digital-un-2026-2/FPGBC_digital_UN/identified_pins/chips.md

## Gowin GW2AR-LV18EQ144PC8/I7 https://www.gowinsemi.com/en/product/arora-ii-fpga/ (placed)

## WCH CH32V203 C8T6 https://www.wch-ic.com/products/CH32V203.html (placed)

## HGSEMI 24C04C  https://www.microchip.com/en-us/product/at24c04c (placed)

## LJ24SA TI 62K CJDC 8 Bit Level Shifter https://www.ti.com/lit/ds/symlink/sn74lvc8t245.pdf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

## YF04E TI 4AK AZD3 4 Bit Level Shifter https://www.ti.com/lit/ds/symlink/txb0104.pdf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

## LPS LP28303A https://www.lowpowersemi.com/Product-detail/17-LP28303A?parent_id=17

## TC8002D Audio Amplifier https://jarl-mie.com/01/image/tec2020/HXJ8002_Miniature_Audio_Amplifier_Datasheet.pdf (placed)

## WINBOND 25Q16JVSIQ SPI Flash https://www.digikey.es/es/products/detail/winbond-electronics/W25Q16JVSSIQ/6193769 (placed)

## EA3059 https://wiki-power.com/en/%E7%94%B5%E6%BA%90%E6%96%B9%E6%A1%88%EF%BC%88PMIC%EF%BC%89-EA3059/ (placed)

## TT5 1D https://www.ti.com/lit/ds/symlink/txs0101.pdf
