digital-un-2026-2/FPGBC_digital_UN/identified_pins/aportes.md

Pines configuracion serial
Samuel Hernandez
David Zorro

Pines eeprom
Diego carvajal
Equipo de la eeprom

Pines de la pantalla
Oscar Arias
Equipo pantalla
