digital-un-2026-2/FPGBC_digital_UN/docs/GB Link Port Connections.jpeg

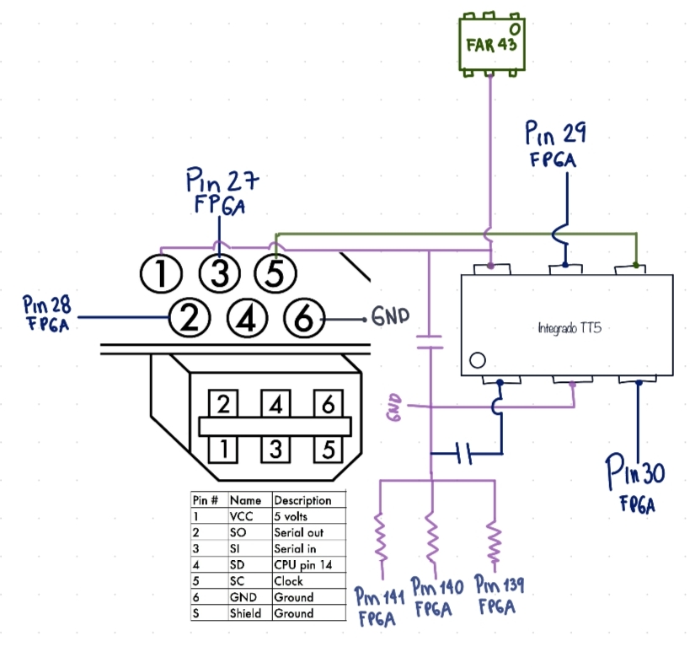
docs/GB Link Port Connections.jpeg
