digital-un-2026-2/FPGBC_digital_UN/docs/GB Link Port Connections.jpg

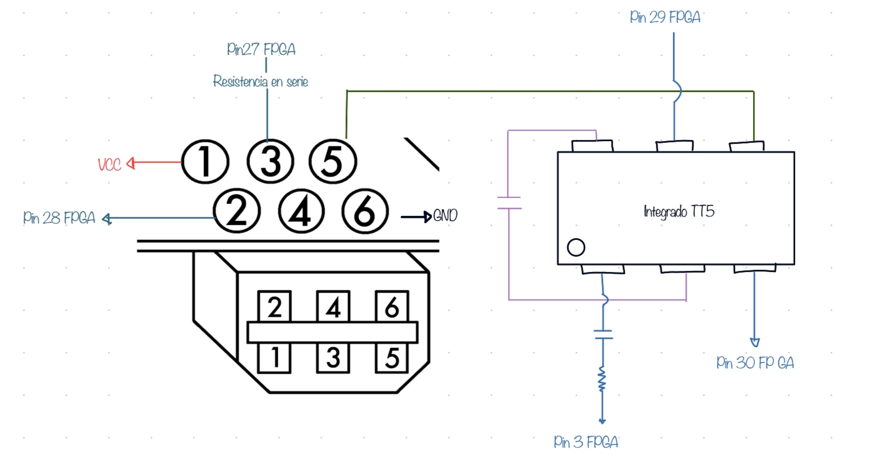
docs/GB Link Port Connections.jpg
