digital-un-2026-2/FPGBC_digital_UN/identified_pins/lqfp144_pinout.png

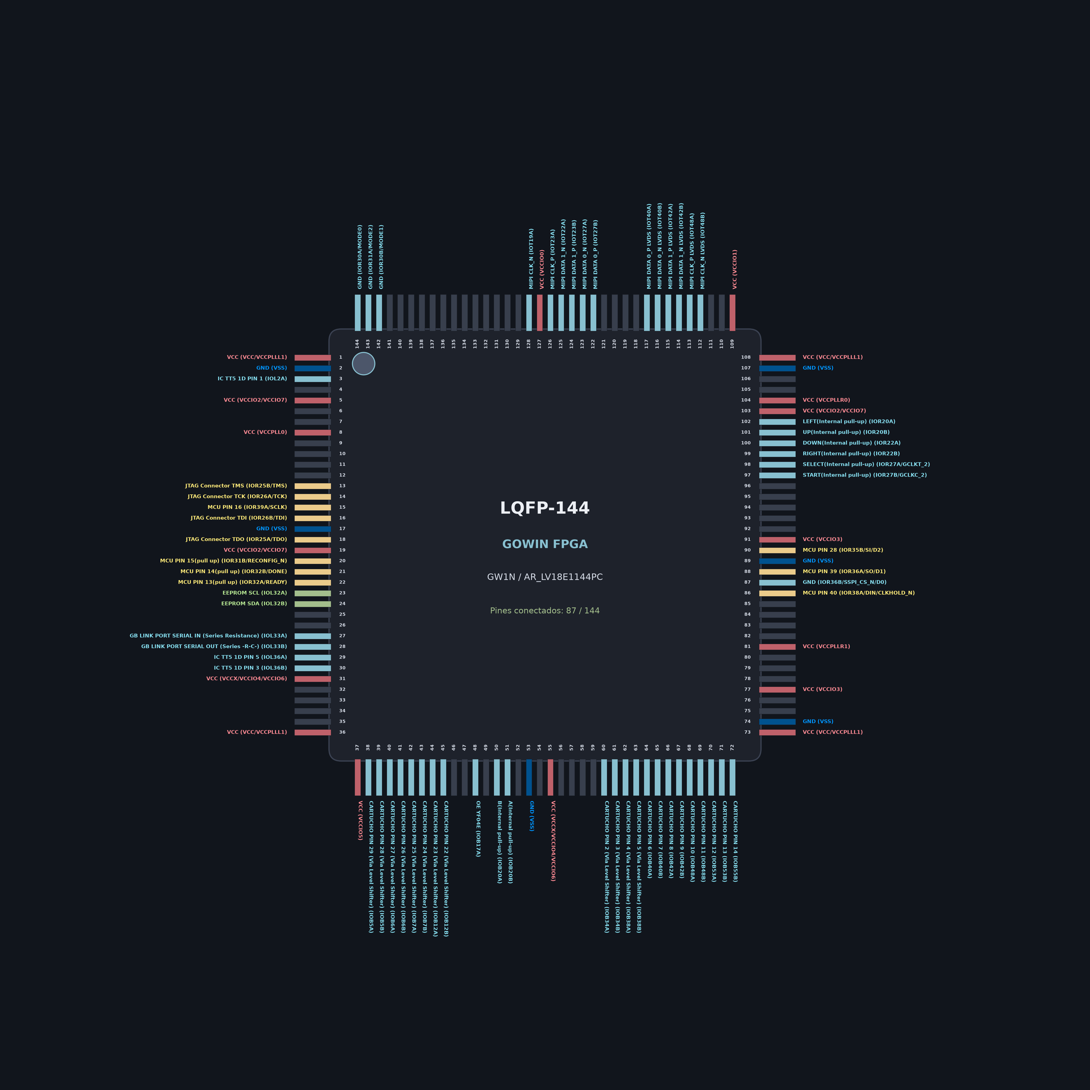
identified_pins/lqfp144_pinout.png
