digital-un-2026-2/FPGBC_digital_UN/schematic/FPGBC_reverse.kicad_pcb

## KiCad design FTDI.kicad_sch

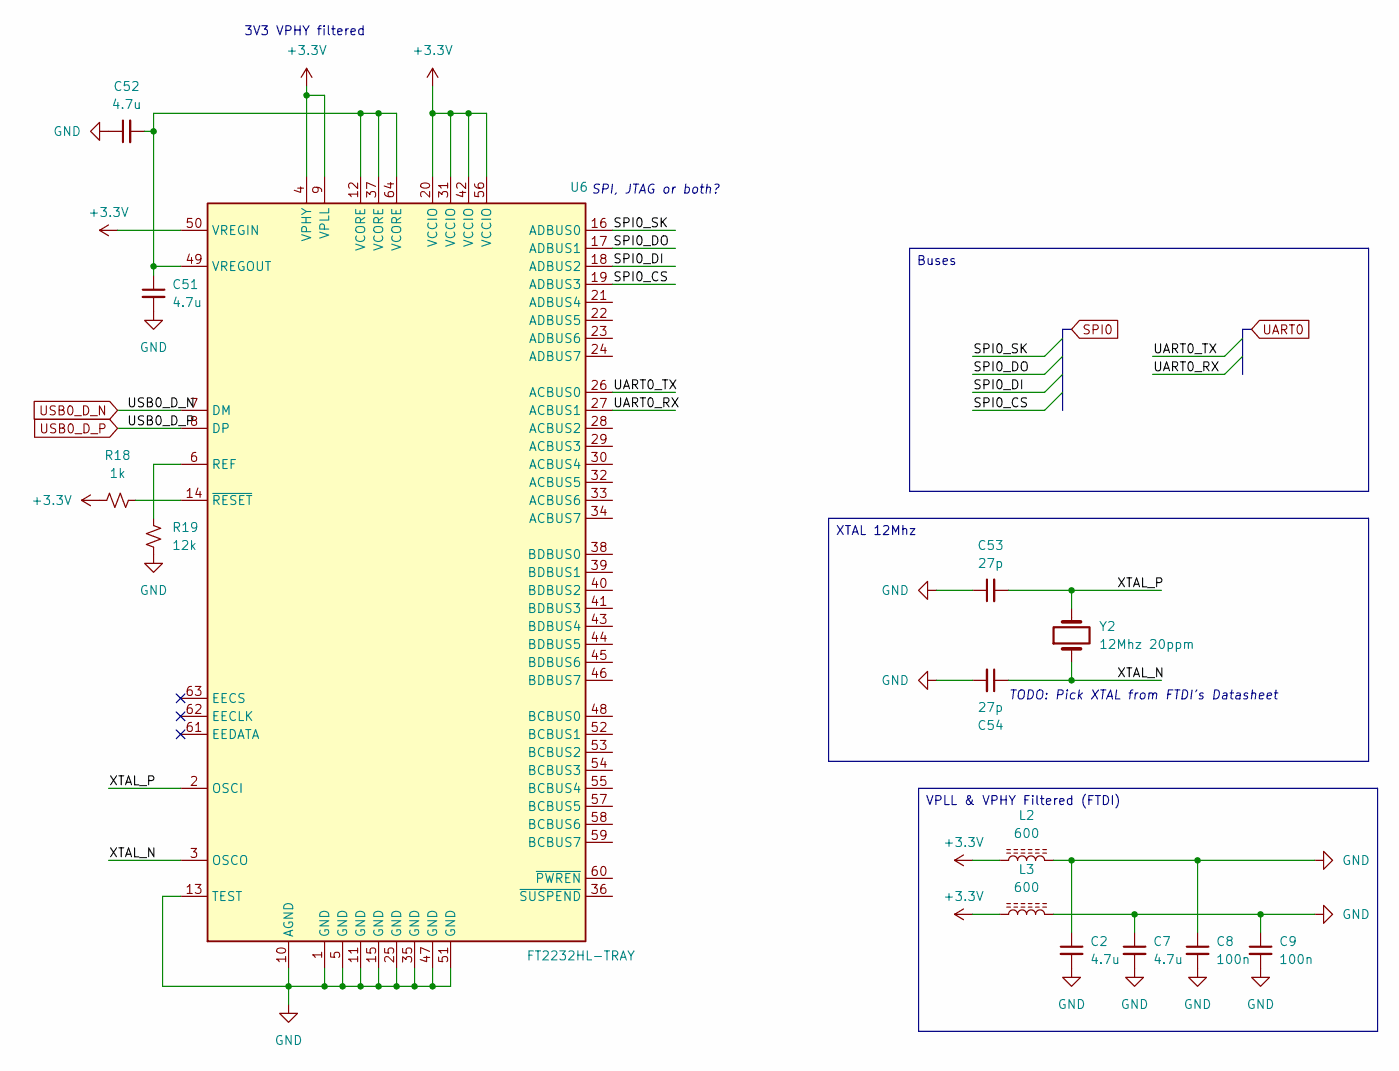
[picture p5: schematic FTDI.kicad_sch]

Parts:
C2, C7, C51, C52: 4.7u
C8, C9: 100n
C53, C54: 27p
L2, L3: 600
R18: 1k
R19: 12k
U6: FT2232HL-TRAY; LQFP-64_10x10mm_P0.5mm
Y2: 12Mhz 20ppm

Connections:
+3.3V: L2.1, L3.1, R18.1, U6.4 (VPHY), U6.9 (VPLL), U6.20 (VCCIO), U6.31 (VCCIO), U6.42 (VCCIO), U6.50 (VREGIN), U6.56 (VCCIO)
GND: C2.1, C2.2, C7.1, C7.2, C8.1, C8.2, C9.1, C9.2, C51.2, C52.1, C53.1, C54.2, L2.2, L3.2, R19.2, U6.1 (GND), U6.5 (GND), U6.10 (AGND), U6.11 (GND), U6.13 (TEST), U6.15 (GND), U6.25 (GND), U6.35 (GND), U6.47 (GND), U6.51 (GND)
unnamed: C51.1, C52.2, U6.12 (VCORE), U6.37 (VCORE), U6.49 (VREGOUT), U6.64 (VCORE)
unnamed: R18.2, U6.14 (~RESET)
unnamed: R19.1, U6.6 (REF)
SPI0_CS: U6.19 (ADBUS3)
SPI0_DI: U6.18 (ADBUS2)
SPI0_DO: U6.17 (ADBUS1)
SPI0_SK: U6.16 (ADBUS0)
UART0_RX: U6.27 (ACBUS1)
UART0_TX: U6.26 (ACBUS0)
USB0_D_N: U6.7 (DM)
USB0_D_P: U6.8 (DP)
XTAL_N: C54.1, U6.3 (OSCO), Y2.1
XTAL_P: C53.2, U6.2 (OSCI), Y2.2

Notes on the sheet:
SPI, JTAG or both?
TODO: Pick XTAL from FTDI's Datasheet
3V3 VPHY filtered
XTAL 12Mhz
Buses
VPLL & VPHY Filtered (FTDI)
