digital-un-2026-2/FPGBC_digital_UN/schematic/FPGBC_reverse.kicad_pcb

## KiCad design io.kicad_sch

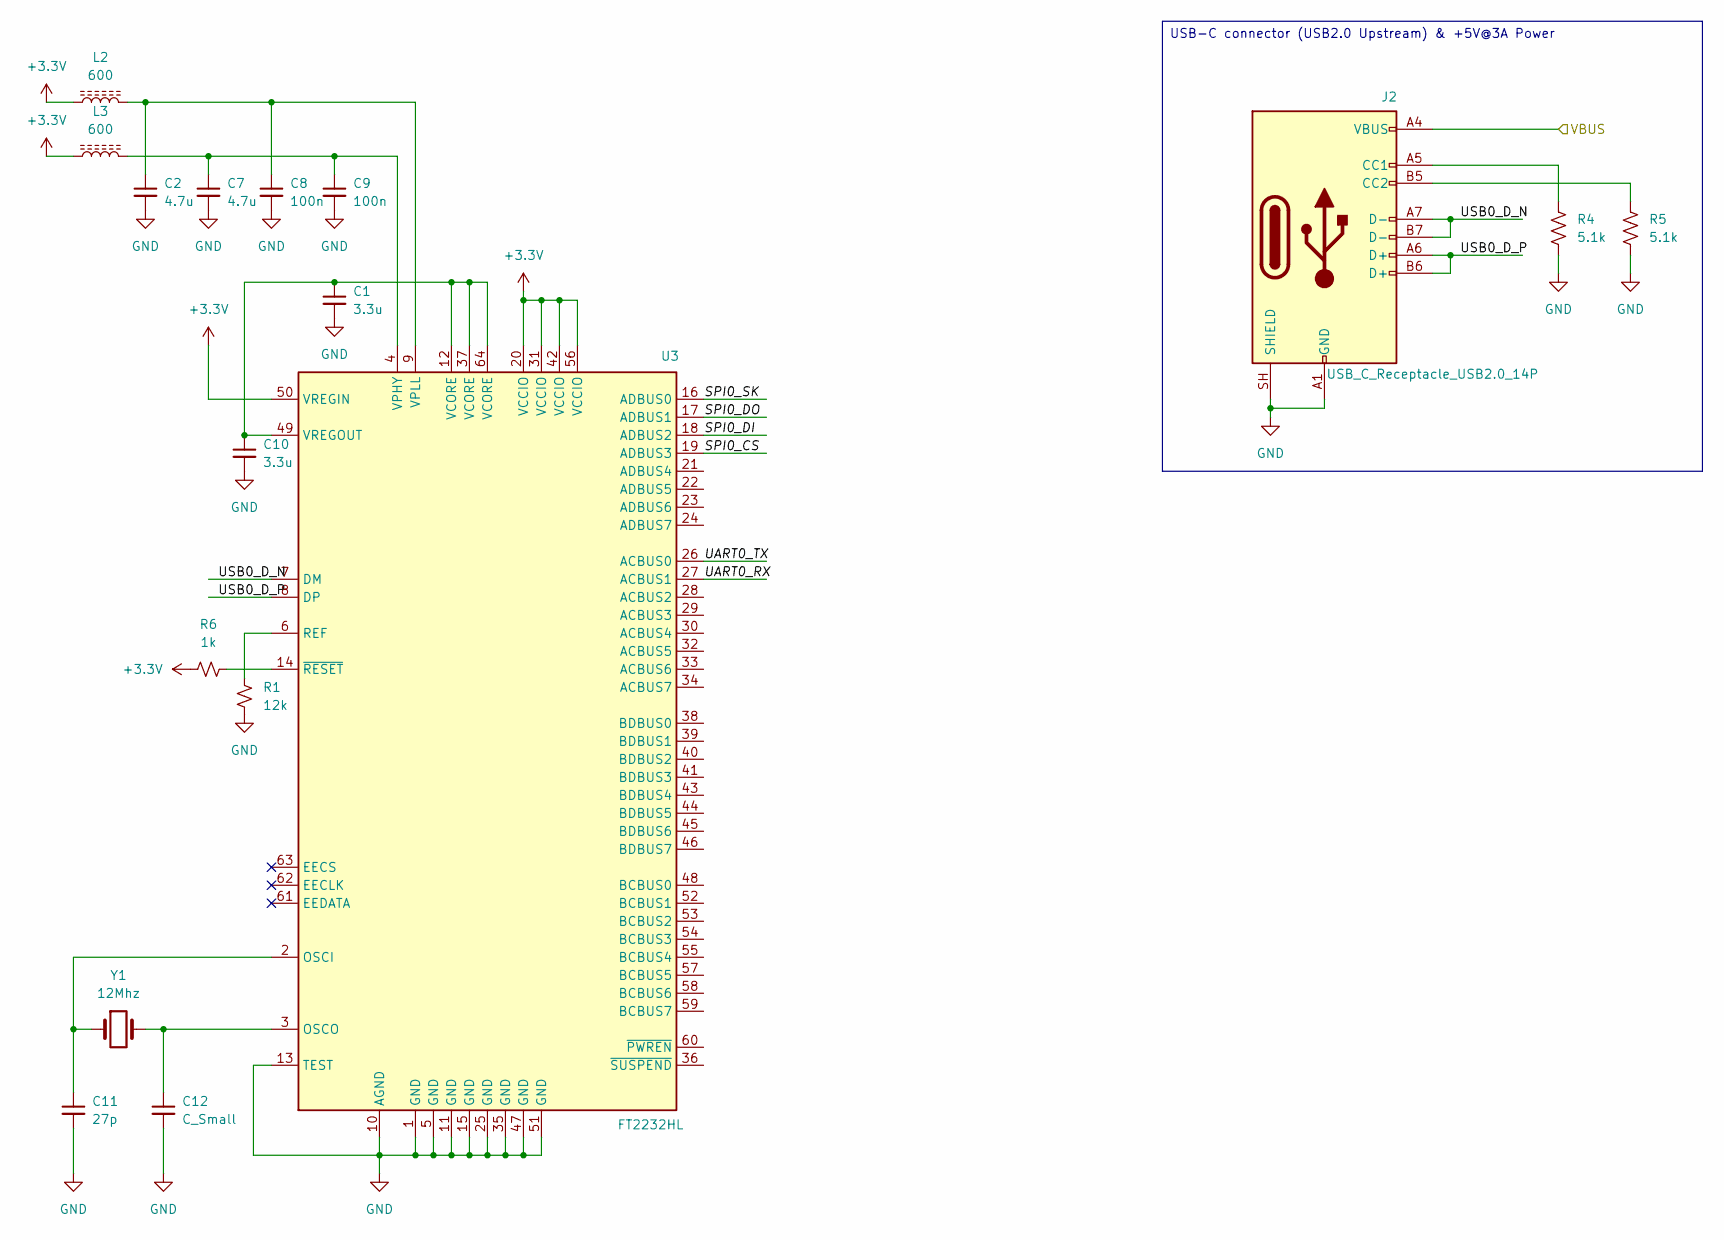
[picture p6: schematic io.kicad_sch]

Parts:
C1, C10: 3.3u
C2, C7: 4.7u
C8, C9: 100n
C11: 27p
C12: C_Small
J2: USB_C_Receptacle_USB2.0_14P
L2, L3: 600
R1: 12k
R4, R5: 5.1k
R6: 1k
U3: FT2232HL; LQFP-64_10x10mm_P0.5mm
Y1: 12Mhz

Connections:
+3.3V: L2.1, L3.1, R6.1, U3.20 (VCCIO), U3.31 (VCCIO), U3.42 (VCCIO), U3.50 (VREGIN), U3.56 (VCCIO)
GND: C1.2, C2.2, C7.2, C8.2, C9.2, C10.2, C11.2, C12.2, J2.A1 (GND), J2.A12 (GND), J2.B1 (GND), J2.B12 (GND), J2.SH (SHIELD), R1.2, R4.2, R5.2, U3.1 (GND), U3.5 (GND), U3.10 (AGND), U3.11 (GND), U3.13 (TEST), U3.15 (GND), U3.25 (GND), U3.35 (GND), U3.47 (GND), U3.51 (GND)
unnamed: C1.1, C10.1, U3.12 (VCORE), U3.37 (VCORE), U3.49 (VREGOUT), U3.64 (VCORE)
unnamed: C2.1, C8.1, L2.2, U3.9 (VPLL)
unnamed: C7.1, C9.1, L3.2, U3.4 (VPHY)
unnamed: C11.1, U3.2 (OSCI), Y1.1
unnamed: C12.1, U3.3 (OSCO), Y1.2
unnamed: J2.A5 (CC1), R4.1
unnamed: J2.B5 (CC2), R5.1
unnamed: R1.1, U3.6 (REF)
unnamed: R6.2, U3.14 (~RESET)
SPI0_CS: U3.19 (ADBUS3)
SPI0_DI: U3.18 (ADBUS2)
SPI0_DO: U3.17 (ADBUS1)
SPI0_SK: U3.16 (ADBUS0)
UART0_RX: U3.27 (ACBUS1)
UART0_TX: U3.26 (ACBUS0)
USB0_D_N: J2.A7 (D-), J2.B7 (D-), U3.7 (DM)
USB0_D_P: J2.A6 (D+), J2.B6 (D+), U3.8 (DP)
VBUS: J2.A4 (VBUS), J2.A9 (VBUS), J2.B4 (VBUS), J2.B9 (VBUS)

Notes on the sheet:
USB-C connector (USB2.0 Upstream) & +5V@3A Power
