digital-un-2026-2/FPGBC_digital_UN/schematic/FPGBC_reverse.kicad_pcb

## KiCad design power.kicad_sch

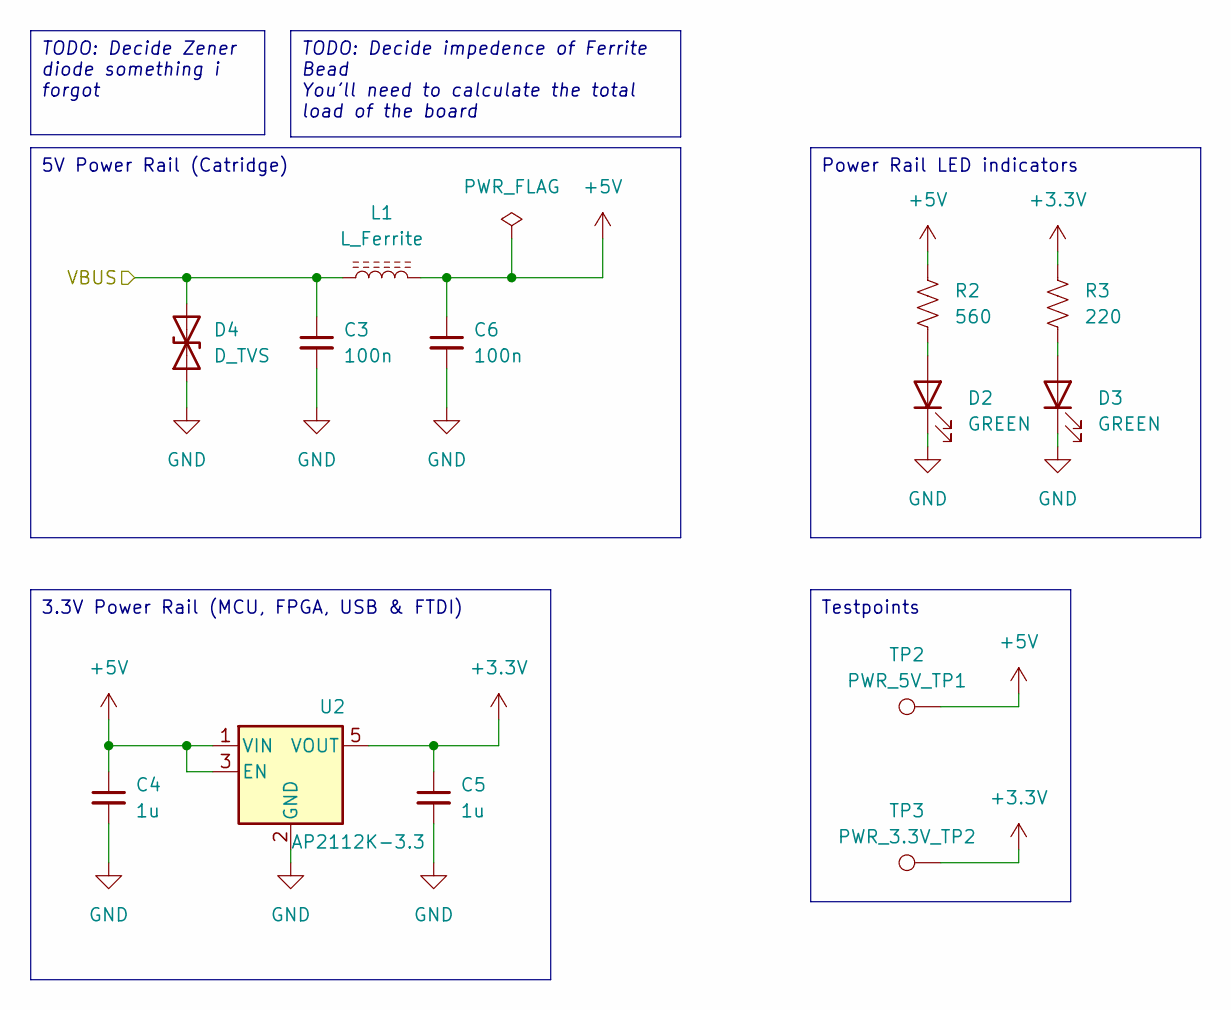
[picture p7: schematic power.kicad_sch]

Parts:
C3, C6: 100n
C4, C5: 1u
D2, D3: GREEN; LED_0805_2012Metric
D4: D_TVS
L1: L_Ferrite
R2: 560
R3: 220
TP2: PWR_5V_TP1
TP3: PWR_3.3V_TP2
U2: AP2112K-3.3; SOT-23-5

Connections:
+3.3V: C5.1, R3.1, TP3.1, U2.5 (VOUT)
+5V: C4.1, C6.1, L1.2, R2.1, TP2.1, U2.1 (VIN), U2.3 (EN)
GND: C3.2, C4.2, C5.2, C6.2, D2.1 (K), D3.1 (K), D4.1 (A1), U2.2 (GND)
unnamed: D2.2 (A), R2.2
unnamed: D3.2 (A), R3.2
VBUS: C3.1, D4.2 (A2), L1.1

Notes on the sheet:
Testpoints
3.3V Power Rail (MCU, FPGA, USB & FTDI)
TODO: Decide Zener diode something i forgot
Power Rail LED indicators
5V Power Rail (Catridge)
TODO: Decide impedence of Ferrite Bead You'll need to calculate the total load of the board
