digital-un-2026-2/FPGBC_digital_UN/test/env/min_soc/README.md

# Obtenido de https://github.com/cicamargoba/digital_UN/tree/main/basic_circuits/test_peripherals/rtl - Commit: 464318d
