digital-un-2026-2/FPGBC_digital_UN/(commit log)

2026-09-22 Identificados algunos pines de la FPGA gowin, simbolos para algunos componentes y esquematico inicial
    [FPGBC_reverse.kicad_pcb, FPGBC_reverse.kicad_sch, gowin_ar_lv18e1144pc.csv]
2026-09-29 más pines
    [FPGBC_reverse.kicad_sch, gowin_ar_lv18e1144pc.csv]
2026-09-29 added display MIPI pins
    [gowin_ar_lv18e1144pc.csv]
2026-10-01 Rebase : Pines de control
    [gowin_ar_lv18e1144pc.csv]
2026-10-01 Rebase : Se añaden pines del GB Link port y documentación
    [gowin_ar_lv18e1144pc.csv]
2026-10-01 Se añaden pines hacia el cartucho
    [gowin_ar_lv18e1144pc.csv]
2026-10-13 Se añaden algunos pines, diagrama de bloques general
2026-10-13 Cambio de nombre de pin a numero de pin
2026-10-20 Se añade instalador para las herramientas usadas en el flujo de diseño software/hardware
2026-10-22 Arreglo a script de instalación de herramientas, no se estaba instalando el toolchain riscv correcto, ahora si
2026-10-22 Se cambia instalación de herramientas y se añaden algunas configuraciones, se añade soc minimo de prueba de el curso
2026-10-24 Se agrega algunos IC al esquematico, se cambia el diagramad de bloques de conexiones, se añade preliminar de arquitectura en bloques
2026-10-26 Analisis de resursos de memoria
2026-10-29 Añadido _platform y _target minimos para la tarjeta
2026-11-02 Añadido soporte de interrupciones para FemtoRV Intermissum, faltan pruebas
2026-11-03 Ejemplo de uso de botones
2026-11-05 Diagrama de soporte para interrupciones lado hardware, caso GPIO In
